guneykunt1904/Open-Source-Ventilation-Device/Mechanical Parts/Photos/Add _part.jpeg

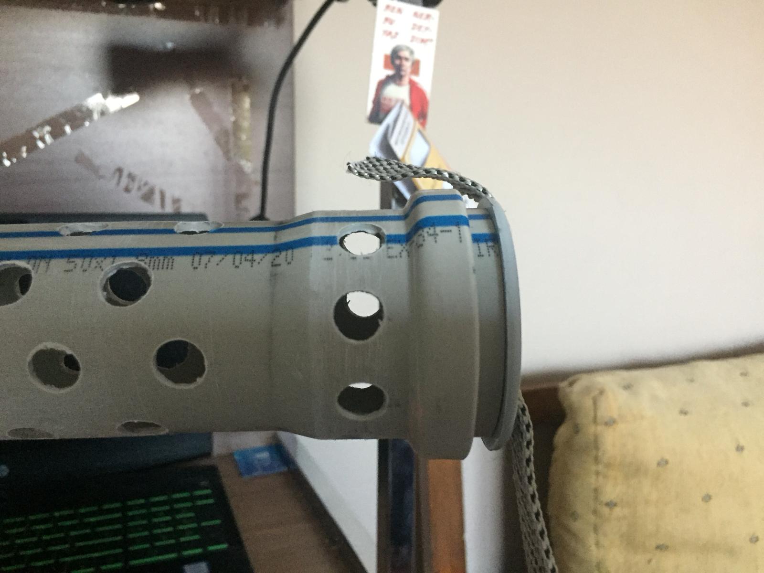
Mechanical Parts/Photos/Add _part.jpeg
