guneykunt1904/Open-Source-Ventilation-Device/Mechanical Parts/Photos/Add_2.jpeg

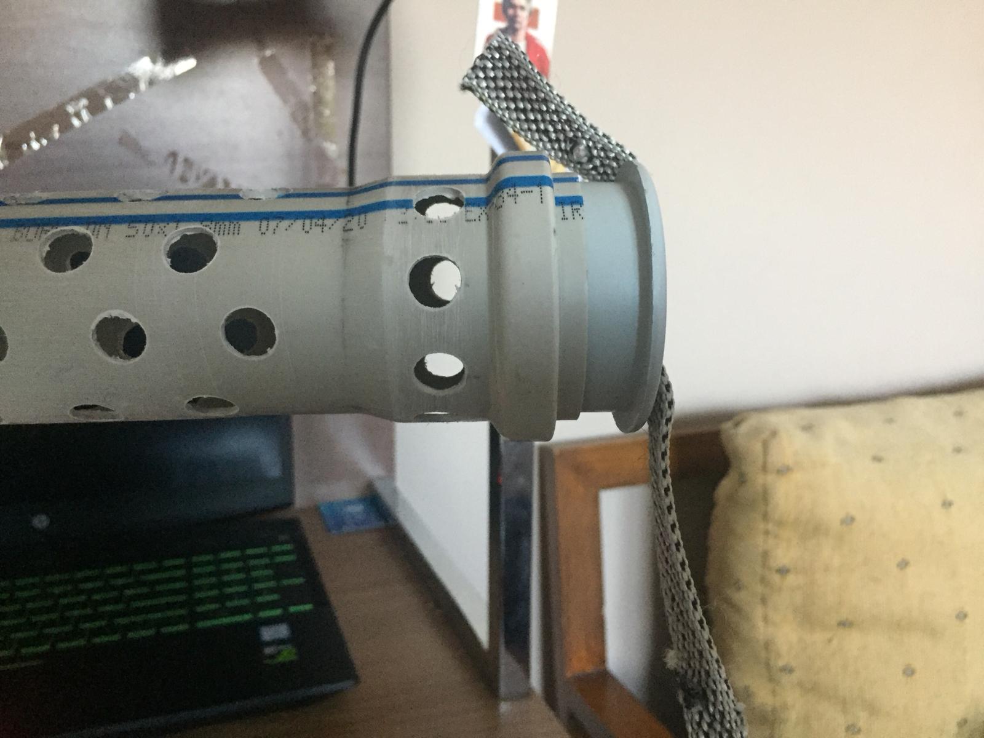
Mechanical Parts/Photos/Add_2.jpeg
