guneykunt1904/Open-Source-Ventilation-Device/Mechanical Parts/Photos/Arm1.jpeg

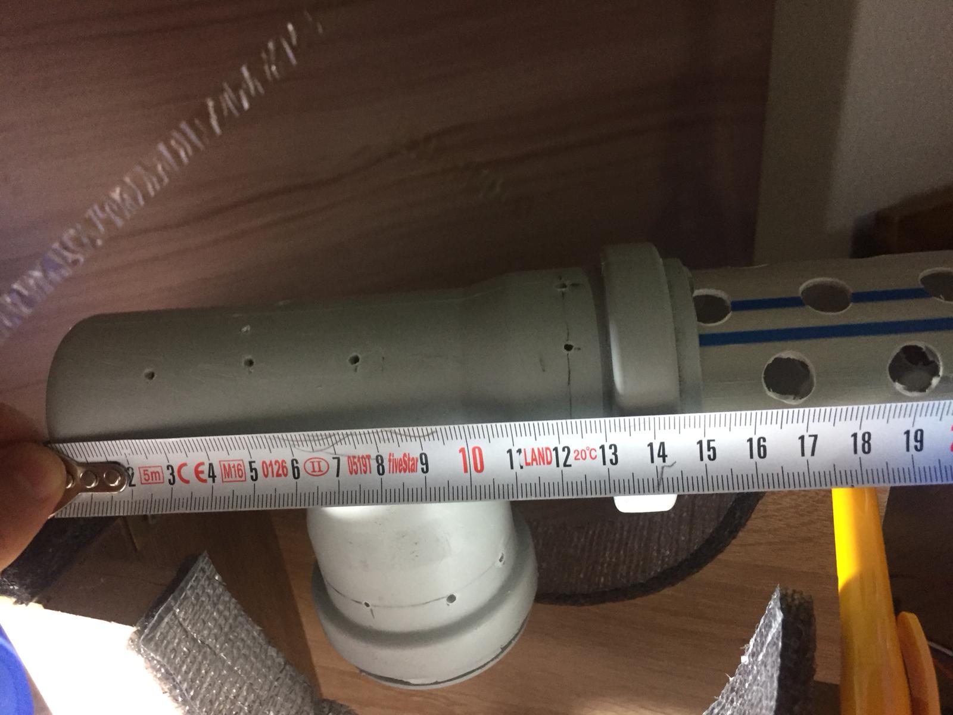
Mechanical Parts/Photos/Arm1.jpeg
