guneykunt1904/Open-Source-Ventilation-Device/Mechanical Parts/Photos/Arm .jpeg

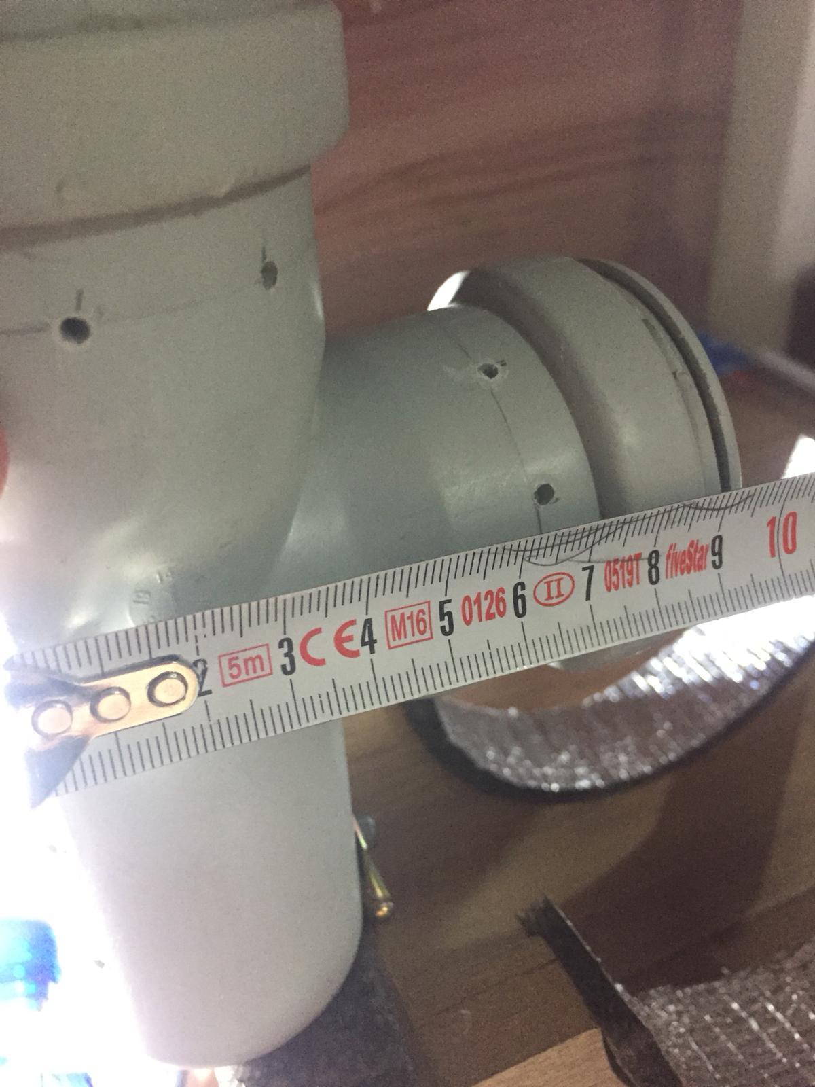
Mechanical Parts/Photos/Arm .jpeg
