guneykunt1904/Open-Source-Ventilation-Device/Mechanical Parts/Photos/Arm Length.jpeg

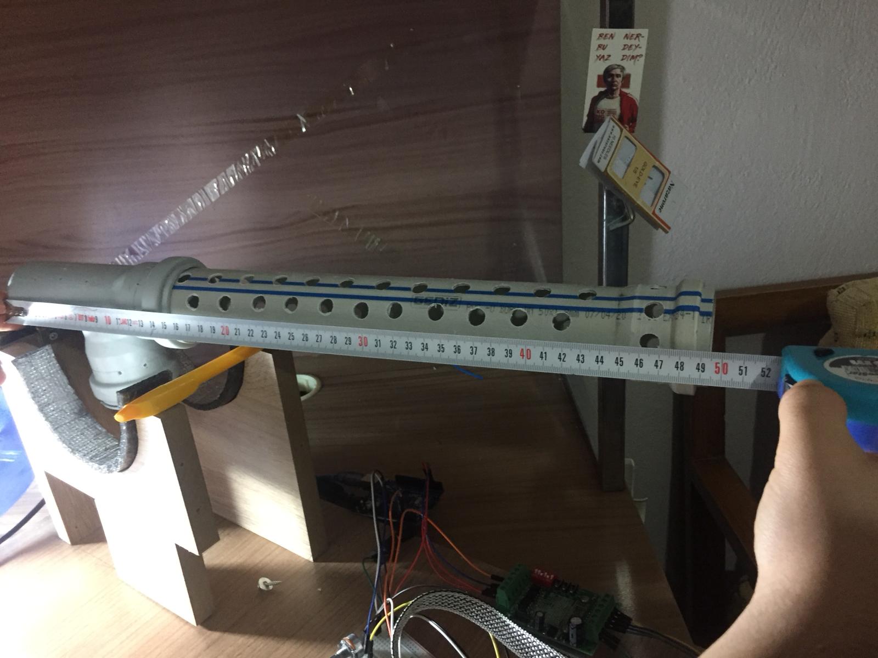
Mechanical Parts/Photos/Arm Length.jpeg
