guneykunt1904/Open-Source-Ventilation-Device/Mechanical Parts/Photos/BWM bag nest  .jpeg

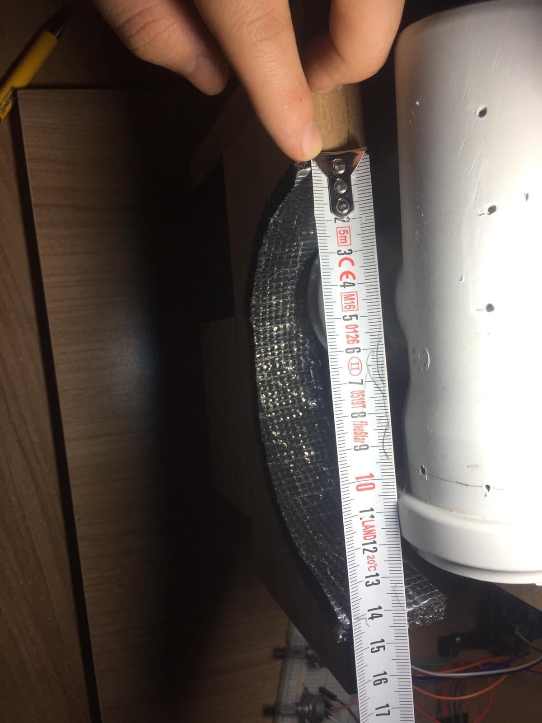
Mechanical Parts/Photos/BWM bag nest .jpeg
