guneykunt1904/Open-Source-Ventilation-Device/Mechanical Parts/Photos/Diameter of arm.jpeg

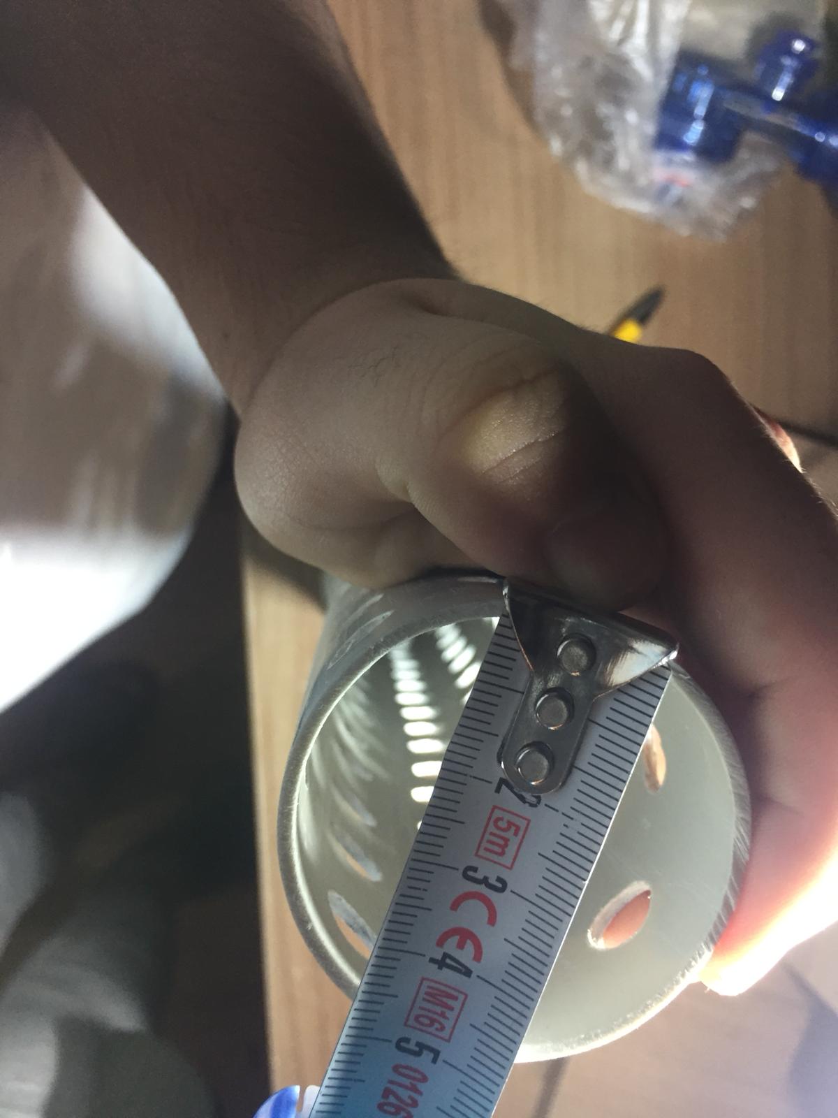
Mechanical Parts/Photos/Diameter of arm.jpeg
