guneykunt1904/Open-Source-Ventilation-Device/Mechanical Parts/Photos/Distance between platform and motor.jpeg

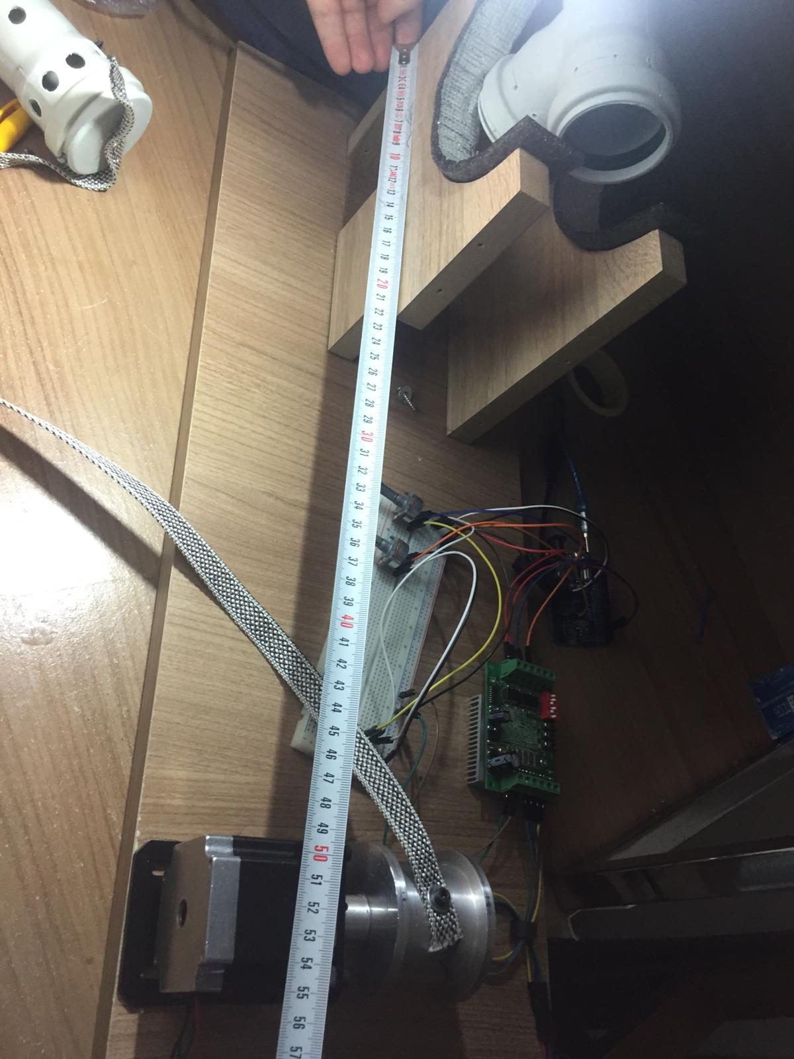
Mechanical Parts/Photos/Distance between platform and motor.jpeg
