guneykunt1904/Open-Source-Ventilation-Device/Mechanical Parts/Photos/Platform Length.jpeg

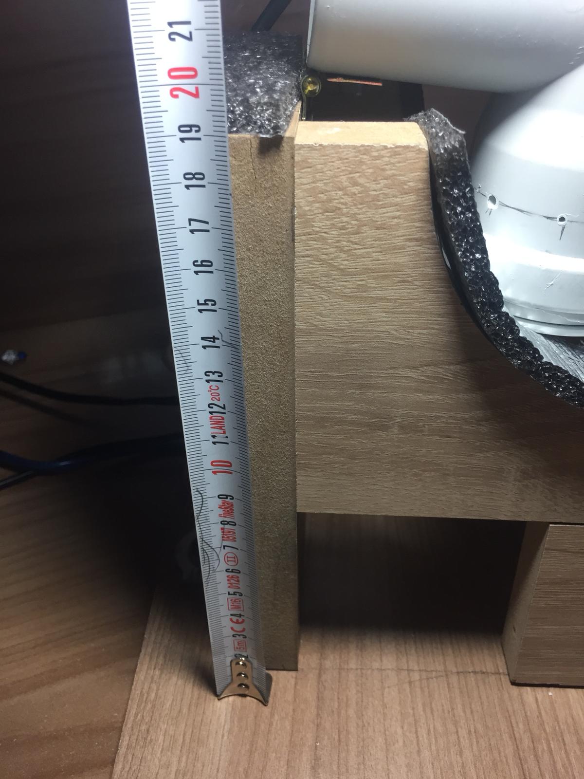
Mechanical Parts/Photos/Platform Length.jpeg
