guneykunt1904/Open-Source-Ventilation-Device/Mechanical Parts/Photos/PLatform Width.jpeg

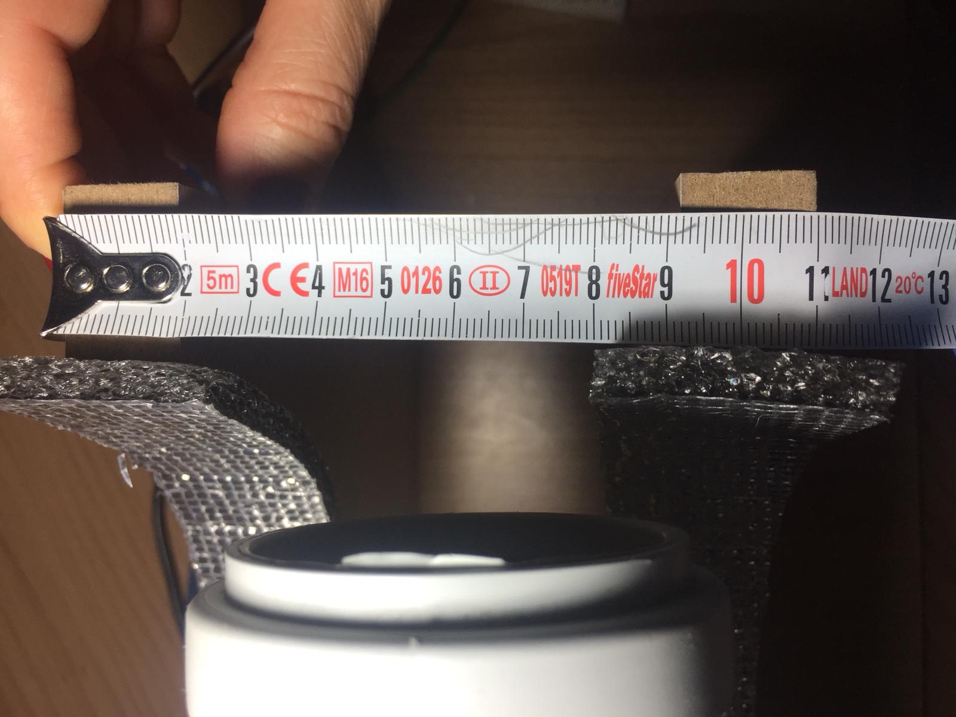
Mechanical Parts/Photos/PLatform Width.jpeg
