guneykunt1904/Open-Source-Ventilation-Device/Mechanical Parts/Photos/Platform measurement.jpeg

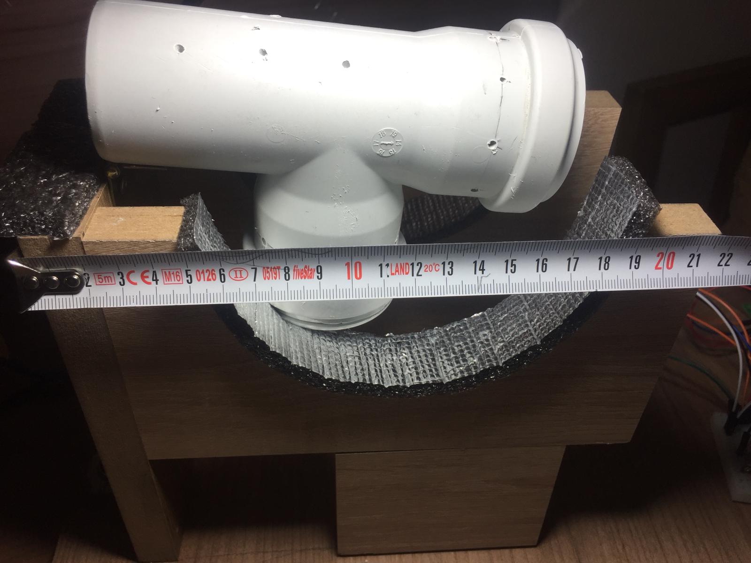
Mechanical Parts/Photos/Platform measurement.jpeg
