guneykunt1904/Open-Source-Ventilation-Device/(threads)

Thread 1 (2020-05-07):

Pressure Sensor

guneykunt1904, 2020-05-07:
# Pressure sensor
We can add pressure sensor but I didn't work on it.If you want to contribute something please contribute
