guneykunt1904/Open-Source-Ventilation-Device/(commit log)

2020-05-07 Create Arduino uno.jpg
2020-05-07 Create Arm .jpeg
2020-05-07 Create Arm Length.jpeg
2020-05-07 Create Diameter of arm.jpeg
2020-05-07 Create Distance between platform and motor.jpeg
